slsgzs-cloud/fitosavia/(commit log)

2026-09-06 Initial public release of FITOSAVIA
    Open hardware/firmware biosensor for early water-stress detection
    in tomato via bioelectrical impedance (ESP32 + ADS1115 + DHT22).
    Includes MIT license, BOM, wiring, method notes, and field notebook.
2026-09-06 Replace firmware with original FITOSAVIA sketch
    Use the author's Anti-Electrólisis ESP32 code as run on hardware.
    [fitosavia.ino]
2026-09-06 Add community docs, CoC, and issue/PR templates
    Scaffold Phase 0–1 for external contributors: CONTRIBUTING,
    CODE_OF_CONDUCT, QUICKSTART/SAFETY, GitHub templates, and a clearer
    README with English summary — without changing firmware behavior.
