slsgzs-cloud/fitosavia/(notices)

Notices in the files:
README.md:
License: MIT
